McMurdo42/MouseDroidVacuum/MouseDroidWithoutTopper.png

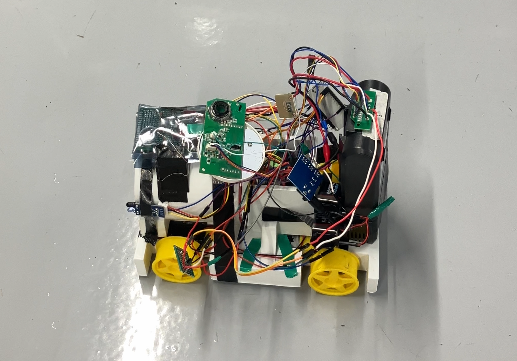
MouseDroidWithoutTopper.png
