McMurdo42/MouseDroidVacuum/Vaccumm.SLDASM

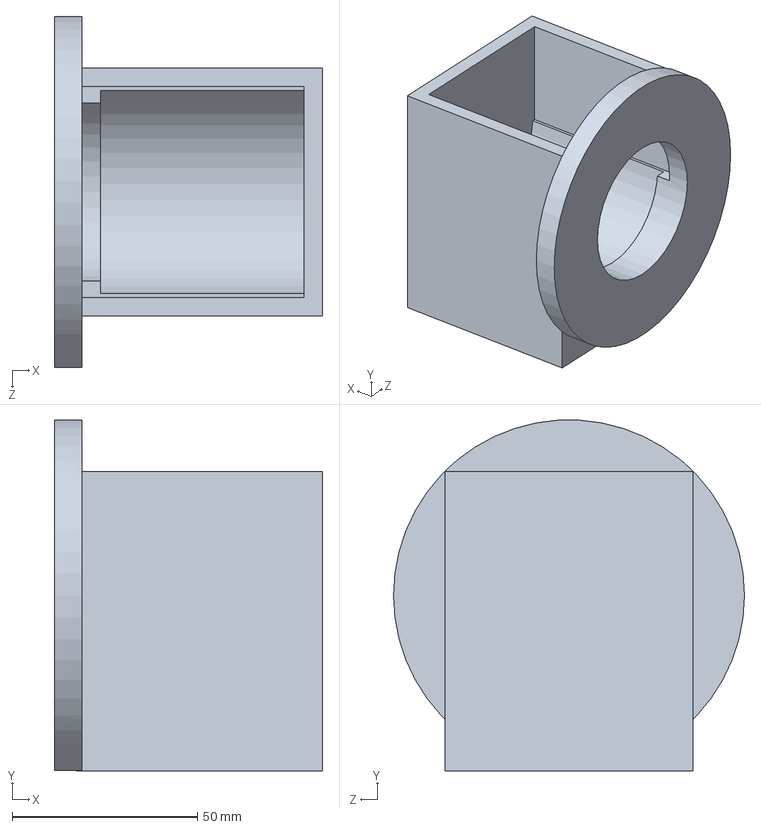
[picture p3: CAD file, 2025-11-13]
Vaccumm.SLDASM
72.5 x 94.7 x 94.8 mm
