McMurdo42/MouseDroidVacuum/ElectricalHousing.SLDPRT

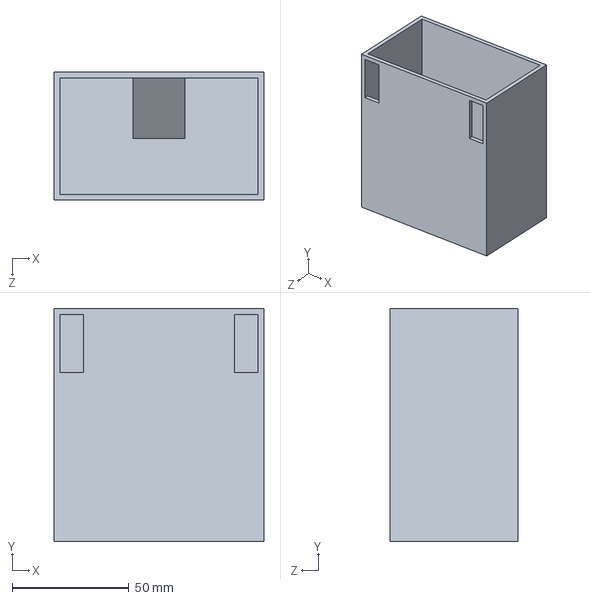
[picture p4: CAD file, 2025-11-15]
ElectricalHousing.SLDPRT
90.0 x 100.0 x 55.0 mm
