McMurdo42/MouseDroidVacuum/Topper.SLDPRT

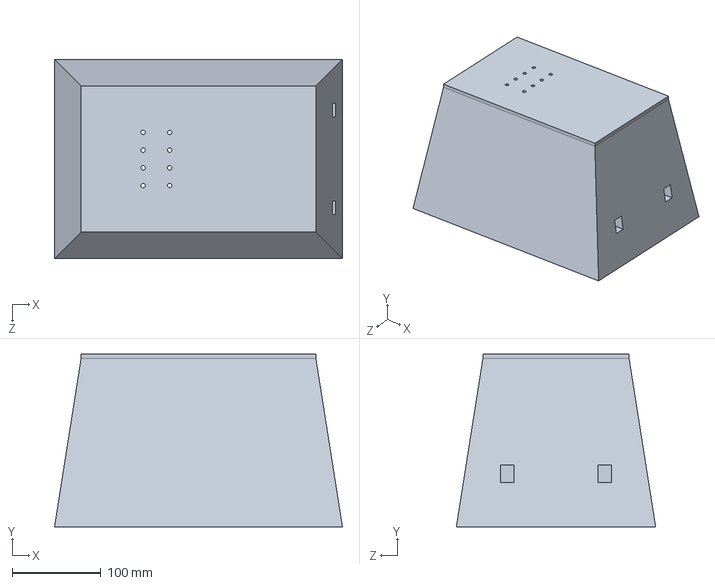
[picture p5: CAD file, 2025-11-15]
Topper.SLDPRT
325.0 x 195.0 x 225.0 mm
