McMurdo42/MouseDroidVacuum/Motor.SLDPRT

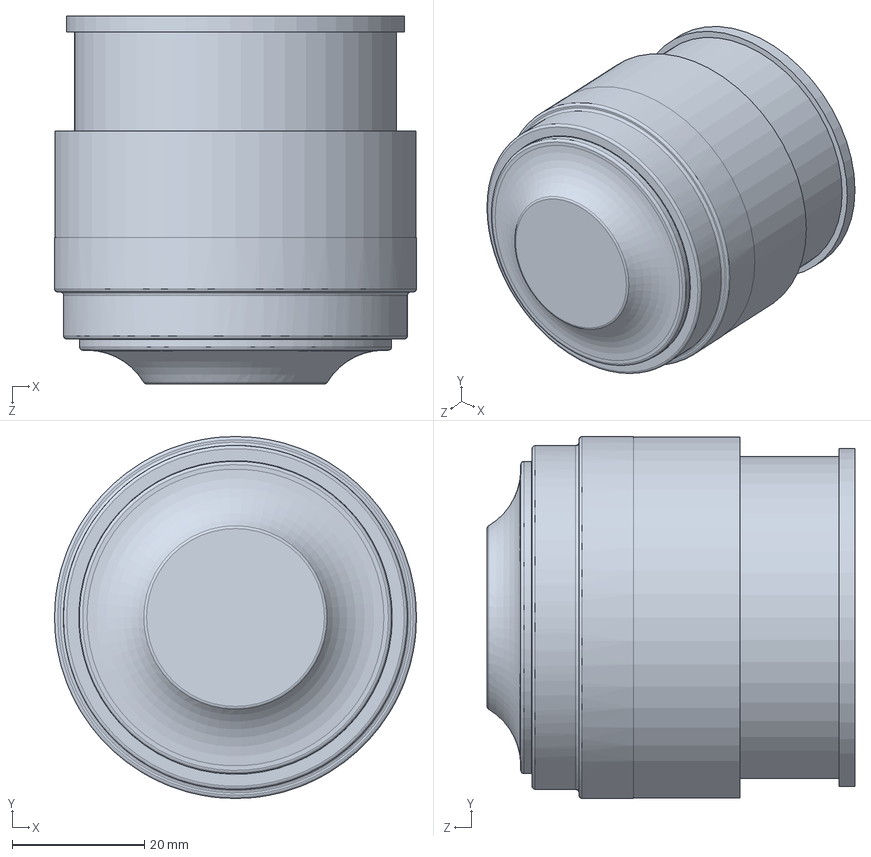
[picture p6: CAD file, 2025-11-13]
Motor.SLDPRT
54.8 x 54.8 x 55.7 mm
