McMurdo42/MouseDroidVacuum/AirChamber.SLDPRT

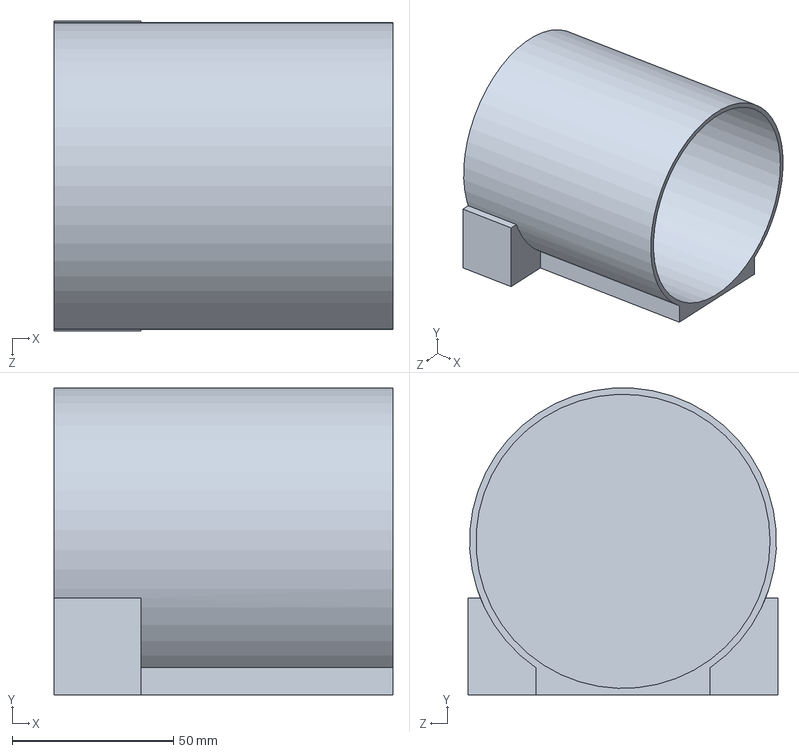
[picture p7: CAD file, 2025-11-13]
AirChamber.SLDPRT
105.0 x 95.0 x 96.0 mm
