McMurdo42/MouseDroidVacuum/Base plate.SLDPRT

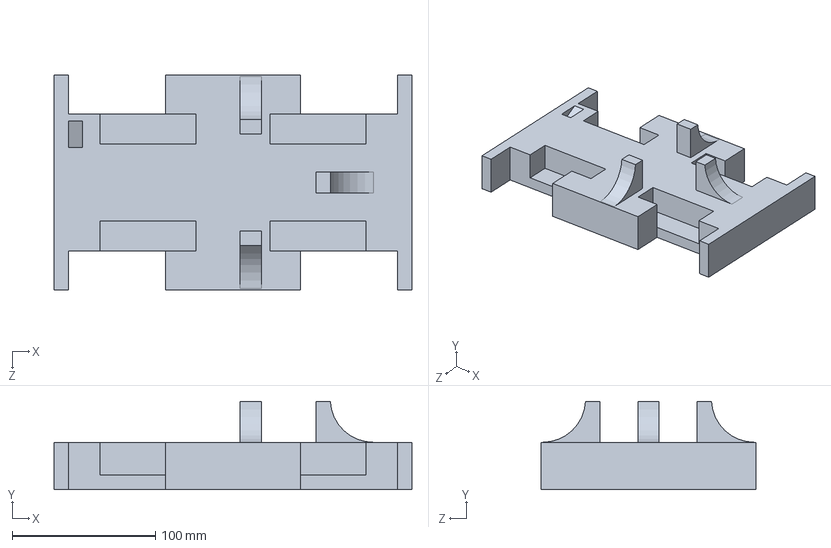
[picture p8: CAD file, 2025-11-13]
Base plate.SLDPRT
250.0 x 61.5 x 150.0 mm
