McMurdo42/MouseDroidVacuum/(list of files, cad)

Other CAD files:
MotorHolder.SLDPRT
