McMurdo42/MouseDroidVacuum/(commit log)

2025-11-13 Initial GitHub Upload
    [AirChamber.SLDPRT, Base plate.SLDPRT, Motor.SLDPRT, MotorHolder.SLDPRT, Vaccumm.SLDASM]
2025-11-15 Designed the topper
    [ElectricalHousing.SLDPRT, Topper.SLDPRT]
